aaronbss/Biometric-Attendance/Database ppt.pptx

PHP PAGE

HOW IS THE DATA TRANSFERRED TO THE DATABASE?

Arduino code using “GET” function.

PHP code using “INSERT” function.

ESP8266

DATABASE

AMAZON WEB SERVICES

## Slide 2

START

FINGER PRESSED

1

1

NO

YES

SCAN

STAFF MEMBER

NO

1

YES

OPTION SELECT

1.

ATTENDANCE

YES

CONFIRM STAFF MEMBER

YES

SCAN

TEACHER

NO

YES

CONFIRM HOD/ADMIN

NO

2.

YES

ENROLL TEACHER

NO

NO

1

ENROLL

NO

STUDENT

YES

STOP PROGRAM

1

DISPLAY ERROR

NO

ENROLL

YES

CONFIRM TEACHER

3.

YES

ENROLL STUDENT

1

ADD TO ARRAY

1

TRANSFER

## Slide 3

TABLES

DIGITAL LOGIC DESIGN

CIRCUIT THEORY

ADVANCED INSTRUMENTATION SYSTEM

DATABASE MANAGEMENT SYSTEM

INSIDE TABLE

COLOUMNS

DATE STAMP

STUDENT DATA

UNIQUE ID NO.

Student data (Present)

ROWS

UNIQUE ID NO.

STUDENT DATA

## Slide 4

Incharge fingerprint

Incharge fingerprint

Selection of subject

Students Scan their fingers

- Authentication to start the attendance module.
- Once subject is selected by teacher the module is
open to all.

- The scanner verifies if a student is indeed a part of the class if yes then
- Kelkar fill up how itll work.
- Teacher incharge once again puts her print in to confirm the attendance is now complete.
